mikaelpfonseca/capacitor_variavel/(list of files, cad)

Other CAD files:
desenho capacitor - peça 1 - rotor.dwg
desenho capacitor - peça 3 - suporte.dwg
desenho capacitor - peça 2 - estator.dwg
