mikaelpfonseca/capacitor_variavel/(threads)

Thread 3 (2020-03-13):

Gerar PDFs dos arquivos .DWG

mikaelpfonseca, 2020-03-13:
Gerar os PDFs dos arquivos do CAD após resolver as demais issues.
